Mr-Clear/FunzelBoard/KiCad/FunzlBoard.stl

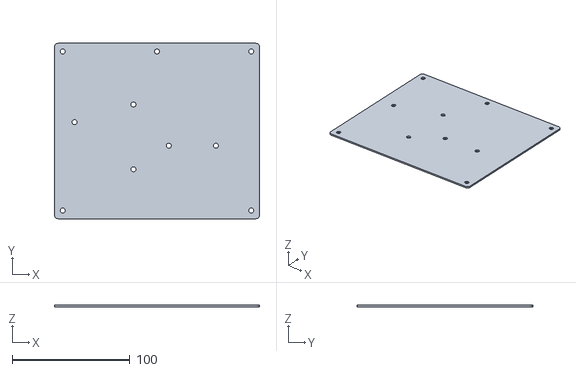
[picture p1: CAD file, 2025-11-04]
KiCad/FunzlBoard.stl
174.0 x 149.0 x 1.51
