Mr-Clear/FunzelBoard/KiCad/FunzlBoard.kicad_pcb

## KiCad design KiCad/FunzlBoard.kicad_pcb (2025-11-17)

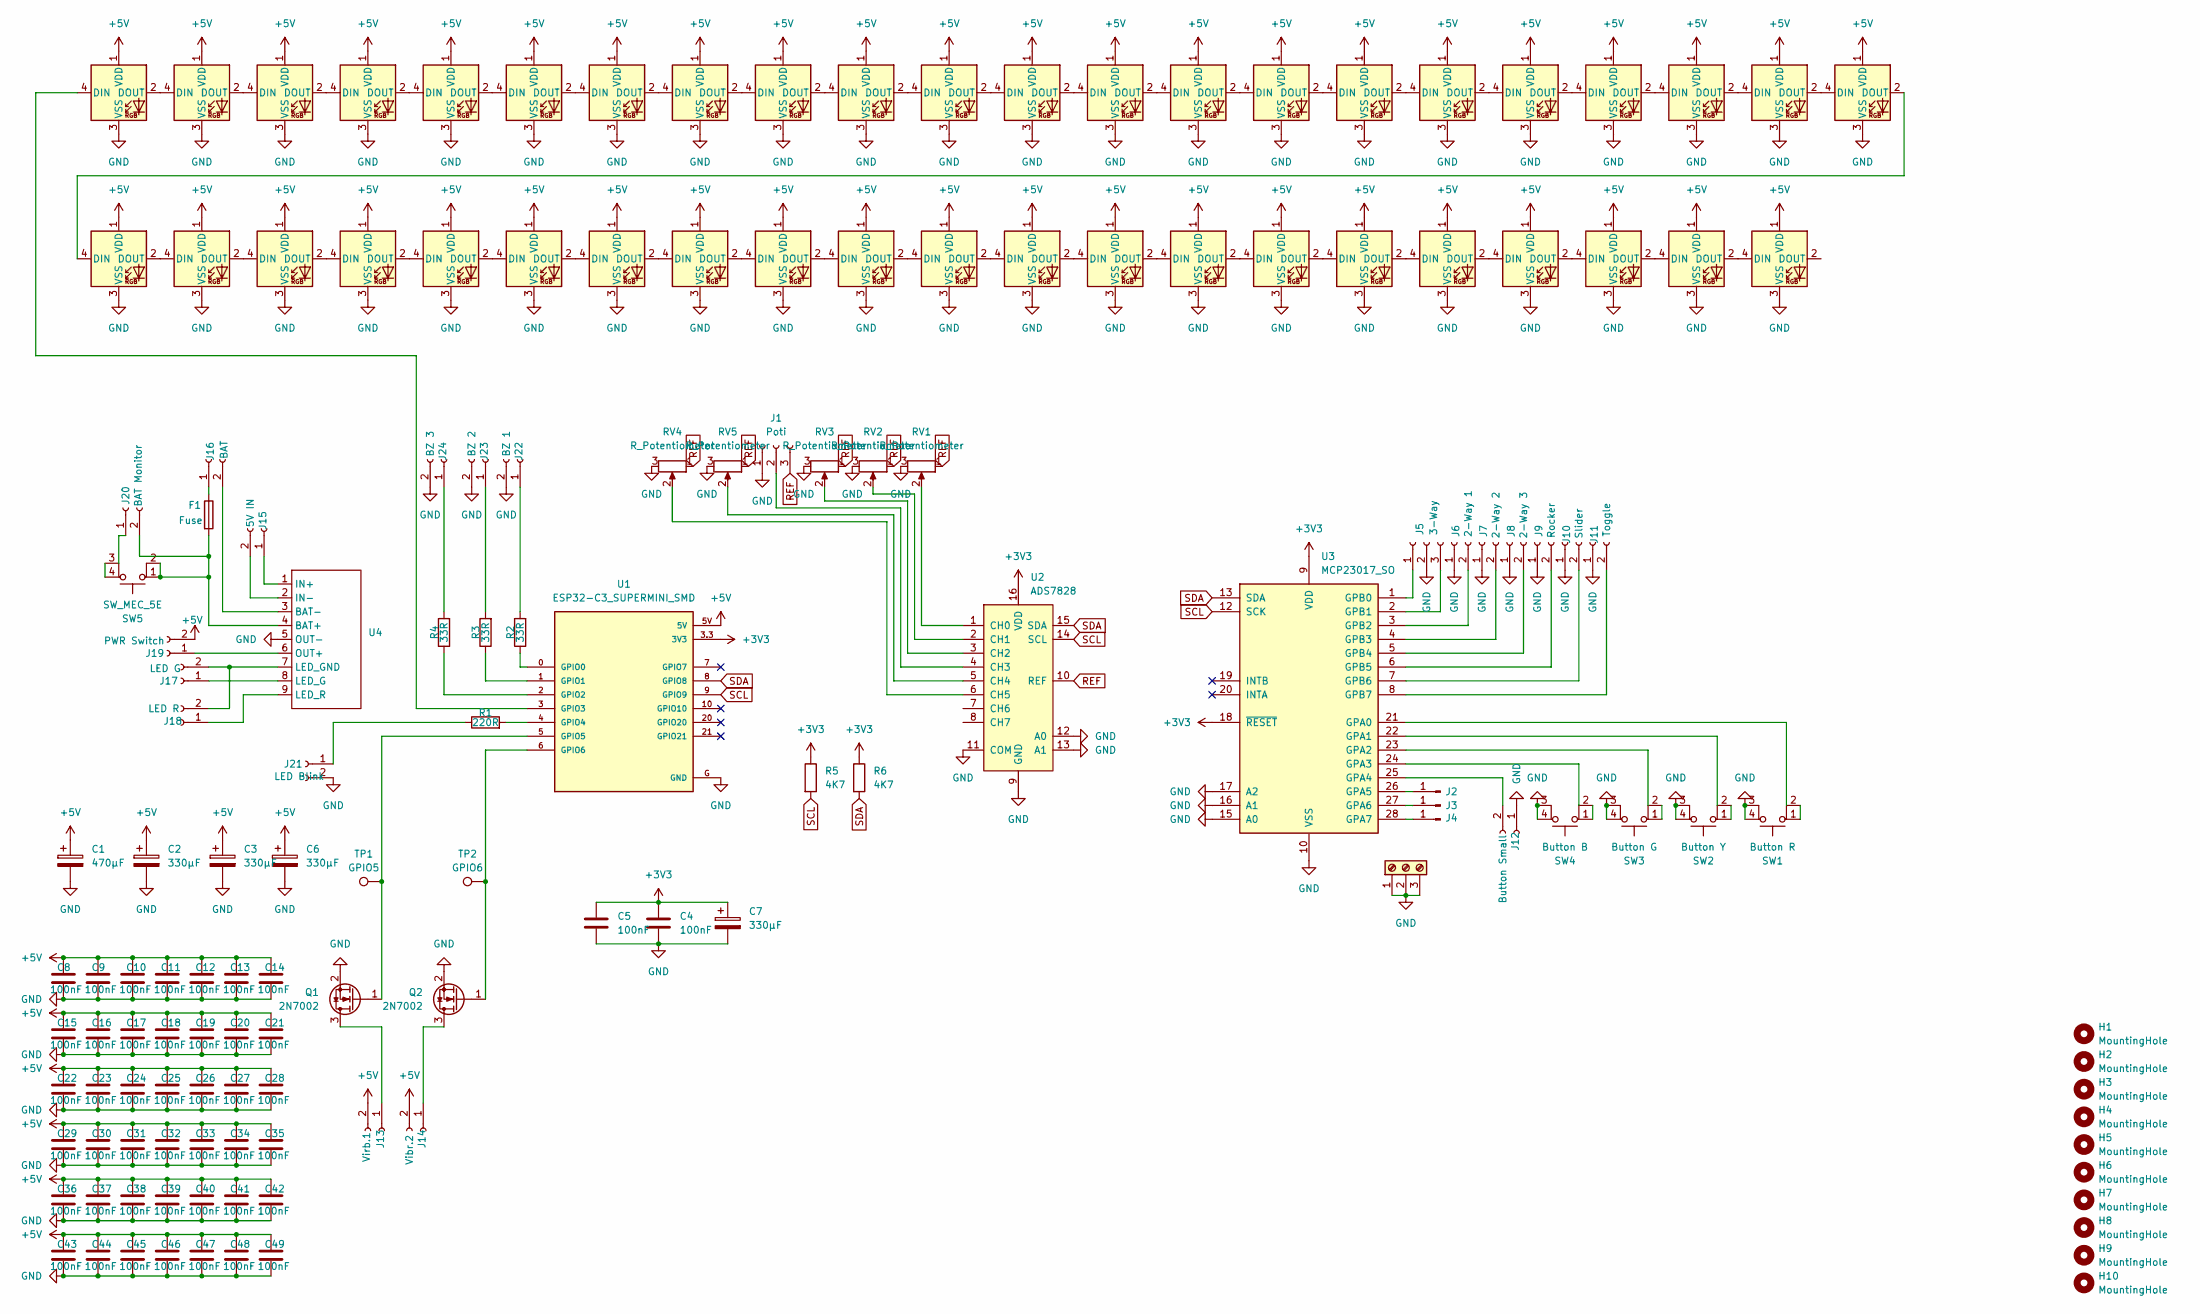
[picture p2: schematic FunzlBoard.kicad_sch]

Parts:
1WI1: Banana Plug Cable; TerminalBlock_Phoenix_MPT-0,5-3-2.54_1x03_P2.54mm_Horizontal
C1: 470µF; CP_Radial_D6.3mm_P2.50mm
C2, C3, C6, C7: 330µF; CP_Radial_D6.3mm_P2.50mm
C4, C5, C8, C9, C10, C11, C12, C13, C14, C15, C16, C17, C18, C19, C20, C21, C22, C23, C24, C25, C26, C27, C28, C29, C30, C31, C32, C33, C34, C35, C36, C37, C38, C39, C40, C41, C42, C43, C44, C45, C46, C47, C48, C49: 100nF; C_1206_3216Metric
D1, D2, D3, D4, D5, D6, D7, D8, D9, D10, D11, D12, D13, D14, D15, D16, D17, D18, D19, D20, D21, D22, D23, D24, D25, D26, D27, D28, D29, D30, D31, D32, D33, D34, D35, D36, D37, D38, D39, D40, D41, D42, D43: WS2812B; LED_WS2812B_PLCC4_5.0x5.0mm_P3.2mm
F1: Fuse; Fuseholder_Clip-5x20mm_Littelfuse_111_Inline_P20.00x5.00mm_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
H1, H2, H3, H4, H5, H6, H7, H8, H9, H10: MountingHole; MountingHole_4.3mm_M4_DIN965
J1: Poti; Connector3
J2: Banana Plug Socket 1; PinHeader_1x01_P2.54mm_Horizontal
J3: Banana Plug Socket 2; PinHeader_1x01_P2.54mm_Horizontal
J4: Banana Plug Socket 3; PinHeader_1x01_P2.54mm_Horizontal
J5: 3-Way; Connector3
J6: 2-Way 1; Connector2
J7: 2-Way 2; Connector2
J8: 2-Way 3; Connector2
J9: Rocker; Connector2
J10: Slider; Connector2
J11: Toggle; Connector2
J12: Button Small; Connector2
J13: Virb.1; Connector2
J14: Vibr.2; Connector2
J15: 5V IN; Connector2
J16: BAT; Connector2
J17: LED G; Connector2
J18: LED R; Connector2
J19: PWR Switch; Connector2
J20: BAT Monitor; Connector2
J21: LED Blink; Connector2
J22: BZ 1; Connector2
J23: BZ 2; Connector2
J24: BZ 3; Connector2
Q1, Q2: 2N7002; SOT-23
R1: 220R; R_1206_3216Metric
R2, R3, R4: 33R; R_1206_3216Metric
R5, R6: 4K7; R_1206_3216Metric
RV1, RV2, RV3: R_Potentiometer; Slider
RV4, RV5: R_Potentiometer; TrimmerH
SW1: Button R; ColorButton
SW2: Button Y; ColorButton
SW3: Button G; ColorButton
SW4: Button B; ColorButton
SW5: SW_MEC_5E; SW_PUSH_6mm_H13mm
TP1: GPIO5; TestPoint_THTPad_D1.5mm_Drill0.7mm
TP2: GPIO6; TestPoint_THTPad_D1.5mm_Drill0.7mm
U1: ESP32-C3_SUPERMINI_SMD; MODULE_ESP32-C3_SUPERMINI
U2: ADS7828; TSSOP-16_4.4x5mm_P0.65mm
U3: MCP23017_SO; SOIC-28W_7.5x17.9mm_P1.27mm
U4: Battery_Management

Connections:
+3V3: C4.1, C5.1, C7.1, R5.1, R6.1, U1.3.3 (3V3), U2.16 (VDD), U3.9 (VDD), U3.18 (~RESET)
+5V: C1.1, C2.1, C3.1, C6.1, C8.1, C9.1, C10.1, C11.1, C12.1, C13.1, C14.1, C15.1, C16.1, C17.1, C18.1, C19.1, C20.1, C21.1, C22.1, C23.1, C24.1, C25.1, C26.1, C27.1, C28.1, C29.1, C30.1, C31.1, C32.1, C33.1, C34.1, C35.1, C36.1, C37.1, C38.1, C39.1, C40.1, C41.1, C42.1, C43.1, C44.1, C45.1, C46.1, C47.1, C48.1, C49.1, D1.1 (VDD), D2.1 (VDD), D3.1 (VDD), D4.1 (VDD), D5.1 (VDD), D6.1 (VDD), D7.1 (VDD), D8.1 (VDD), D9.1 (VDD), D10.1 (VDD), D11.1 (VDD), D12.1 (VDD), D13.1 (VDD), D14.1 (VDD), D15.1 (VDD), D16.1 (VDD), D17.1 (VDD), D18.1 (VDD), D19.1 (VDD), D20.1 (VDD), D21.1 (VDD), D22.1 (VDD), D23.1 (VDD), D24.1 (VDD), D25.1 (VDD), D26.1 (VDD), D27.1 (VDD), D28.1 (VDD), D29.1 (VDD), D30.1 (VDD), D31.1 (VDD), D32.1 (VDD), D33.1 (VDD), D34.1 (VDD), D35.1 (VDD), D36.1 (VDD), D37.1 (VDD), D38.1 (VDD), D39.1 (VDD), D40.1 (VDD), D41.1 (VDD), D42.1 (VDD), D43.1 (VDD), J13.2, J14.2, J19.2, U1.5V
GND: 1WI1.1 (GND), 1WI1.2 (GND), 1WI1.3 (GND), C1.2, C2.2, C3.2, C4.2, C5.2, C6.2, C7.2, C8.2, C9.2, C10.2, C11.2, C12.2, C13.2, C14.2, C15.2, C16.2, C17.2, C18.2, C19.2, C20.2, C21.2, C22.2, C23.2, C24.2, C25.2, C26.2, C27.2, C28.2, C29.2, C30.2, C31.2, C32.2, C33.2, C34.2, C35.2, C36.2, C37.2, C38.2, C39.2, C40.2, C41.2, C42.2, C43.2, C44.2, C45.2, C46.2, C47.2, C48.2, C49.2, D1.3 (VSS), D2.3 (VSS), D3.3 (VSS), D4.3 (VSS), D5.3 (VSS), D6.3 (VSS), D7.3 (VSS), D8.3 (VSS), D9.3 (VSS), D10.3 (VSS), D11.3 (VSS), D12.3 (VSS), D13.3 (VSS), D14.3 (VSS), D15.3 (VSS), D16.3 (VSS), D17.3 (VSS), D18.3 (VSS), D19.3 (VSS), D20.3 (VSS), D21.3 (VSS), D22.3 (VSS), D23.3 (VSS), D24.3 (VSS), D25.3 (VSS), D26.3 (VSS), D27.3 (VSS), D28.3 (VSS), D29.3 (VSS), D30.3 (VSS), D31.3 (VSS), D32.3 (VSS), D33.3 (VSS), D34.3 (VSS), D35.3 (VSS), D36.3 (VSS), D37.3 (VSS), D38.3 (VSS), D39.3 (VSS), D40.3 (VSS), D41.3 (VSS), D42.3 (VSS), D43.3 (VSS), J1.1, J5.2, J6.1, J7.1, J8.1, J9.1, J10.1, J11.1, J12.1, J21.2, J22.2, J23.2, J24.2, Q1.2 (S), Q2.2 (S), RV1.3, RV2.3, RV3.3, RV4.3, RV5.3, SW1.3 (K), SW1.4 (A), SW2.3 (K), SW2.4 (A), SW3.3 (K), SW3.4 (A), SW4.3 (K), SW4.4 (A), U1.G (GND), U2.9 (GND), U2.11 (COM), U2.12 (A0), U2.13 (A1), U3.10 (VSS), U3.15 (A0), U3.16 (A1), U3.17 (A2), U4.5 (OUT-)
unnamed: D1.4 (DIN), U1.3 (GPIO3)
unnamed: D1.2 (DOUT), D2.4 (DIN)
unnamed: D2.2 (DOUT), D3.4 (DIN)
unnamed: D3.2 (DOUT), D4.4 (DIN)
unnamed: D4.2 (DOUT), D5.4 (DIN)
unnamed: D5.2 (DOUT), D6.4 (DIN)
unnamed: D6.2 (DOUT), D7.4 (DIN)
unnamed: D7.2 (DOUT), D8.4 (DIN)
unnamed: D8.2 (DOUT), D9.4 (DIN)
unnamed: D9.2 (DOUT), D10.4 (DIN)
unnamed: D10.2 (DOUT), D11.4 (DIN)
unnamed: D11.2 (DOUT), D12.4 (DIN)
unnamed: D12.2 (DOUT), D13.4 (DIN)
unnamed: D13.2 (DOUT), D14.4 (DIN)
unnamed: D14.2 (DOUT), D15.4 (DIN)
unnamed: D15.2 (DOUT), D16.4 (DIN)
unnamed: D16.2 (DOUT), D17.4 (DIN)
unnamed: D17.2 (DOUT), D18.4 (DIN)
unnamed: D18.2 (DOUT), D19.4 (DIN)
unnamed: D19.2 (DOUT), D20.4 (DIN)
unnamed: D20.2 (DOUT), D21.4 (DIN)
unnamed: D21.2 (DOUT), D22.4 (DIN)
unnamed: D22.2 (DOUT), D23.4 (DIN)
unnamed: D23.2 (DOUT), D24.4 (DIN)
unnamed: D24.2 (DOUT), D25.4 (DIN)
unnamed: D25.2 (DOUT), D26.4 (DIN)
unnamed: D26.2 (DOUT), D27.4 (DIN)
unnamed: D27.2 (DOUT), D28.4 (DIN)
unnamed: D28.2 (DOUT), D29.4 (DIN)
unnamed: D29.2 (DOUT), D30.4 (DIN)
unnamed: D30.2 (DOUT), D31.4 (DIN)
unnamed: D31.2 (DOUT), D32.4 (DIN)
unnamed: D32.2 (DOUT), D33.4 (DIN)
unnamed: D33.2 (DOUT), D34.4 (DIN)
unnamed: D34.2 (DOUT), D35.4 (DIN)
unnamed: D35.2 (DOUT), D36.4 (DIN)
unnamed: D36.2 (DOUT), D37.4 (DIN)
unnamed: D37.2 (DOUT), D38.4 (DIN)
unnamed: D38.2 (DOUT), D39.4 (DIN)
unnamed: D39.2 (DOUT), D40.4 (DIN)
unnamed: D40.2 (DOUT), D41.4 (DIN)
unnamed: D41.2 (DOUT), D42.4 (DIN)
unnamed: D42.2 (DOUT), D43.4 (DIN)
unnamed: J1.2, U2.4 (CH3)
unnamed: J2.1, U3.26 (GPA5)
unnamed: J3.1, U3.27 (GPA6)
unnamed: J4.1, U3.28 (GPA7)
unnamed: J5.1, U3.1 (GPB0)
unnamed: J5.3, U3.2 (GPB1)
unnamed: J6.2, U3.3 (GPB2)
unnamed: J7.2, U3.4 (GPB3)
unnamed: J8.2, U3.5 (GPB4)
unnamed: J9.2, U3.6 (GPB5)
unnamed: J10.2, U3.7 (GPB6)
unnamed: J11.2, U3.8 (GPB7)
unnamed: J12.2, U3.25 (GPA4)
unnamed: J13.1, Q1.3 (D)
unnamed: J14.1, Q2.3 (D)
unnamed: J15.1, U4.1 (IN+)
unnamed: J15.2, U4.2 (IN-)
unnamed: F1.1, J16.1
unnamed: J16.2, U4.3 (BAT-)
unnamed: J17.1, U4.8 (LED_G)
unnamed: J17.2, J18.2, U4.7 (LED_GND)
unnamed: J18.1, U4.9 (LED_R)
unnamed: J19.1, U4.6 (OUT+)
unnamed: F1.2, J20.2, SW5.1, SW5.2, U4.4 (BAT+)
unnamed: J21.1, R1.1
unnamed: J22.1, R2.2
unnamed: J23.1, R3.2
unnamed: J24.1, R4.2
unnamed: Q1.1 (G), TP1.1, U1.5 (GPIO5)
unnamed: Q2.1 (G), TP2.1, U1.6 (GPIO6)
unnamed: SW1.1, SW1.2
unnamed: SW2.1, SW2.2
unnamed: SW3.1, SW3.2
unnamed: SW4.1, SW4.2
unnamed: SW5.3 (K), SW5.4 (A)
unnamed: R2.1, U1.0 (GPIO0)
unnamed: R3.1, U1.1 (GPIO1)
unnamed: R4.1, U1.2 (GPIO2)
unnamed: R1.2, U1.4 (GPIO4)
unnamed: RV1.2, U2.1 (CH0)
unnamed: RV2.2, U2.2 (CH1)
unnamed: RV3.2, U2.3 (CH2)
unnamed: RV5.2, U2.5 (CH4)
unnamed: RV4.2, U2.6 (CH5)
REF: J1.3, RV1.1, RV2.1, RV3.1, RV4.1, RV5.1, U2.10 (REF)
SCL: R5.2, U1.9 (GPIO9), U2.14 (SCL), U3.12 (SCK)
SDA: R6.2, U1.8 (GPIO8), U2.15 (SDA), U3.13 (SDA)

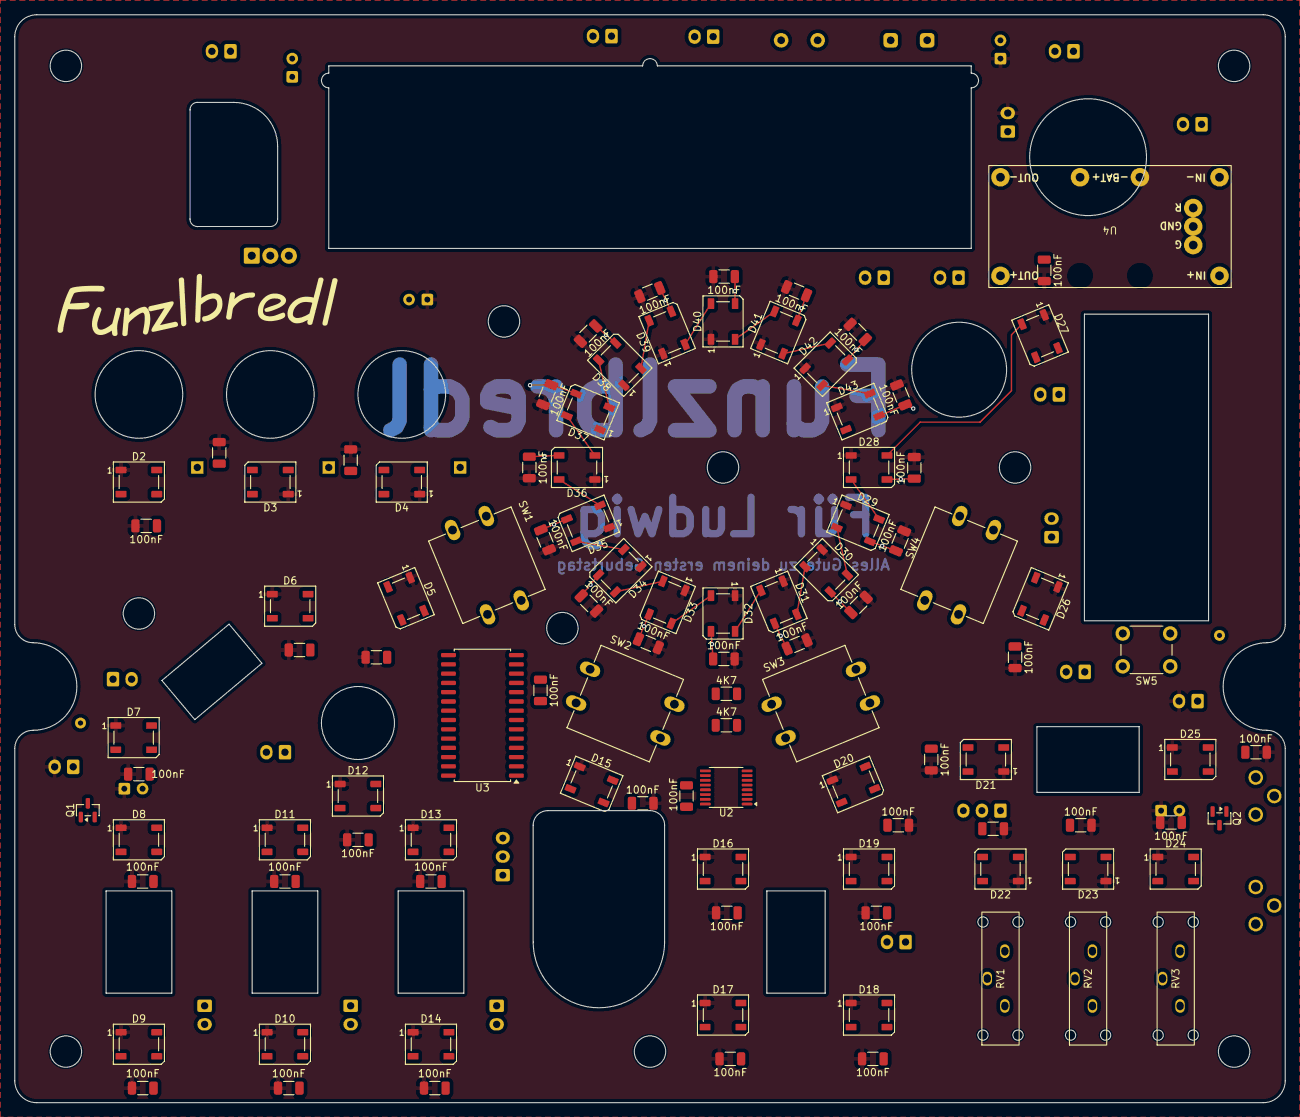
[picture p3: board FunzlBoard.kicad_pcb from above]

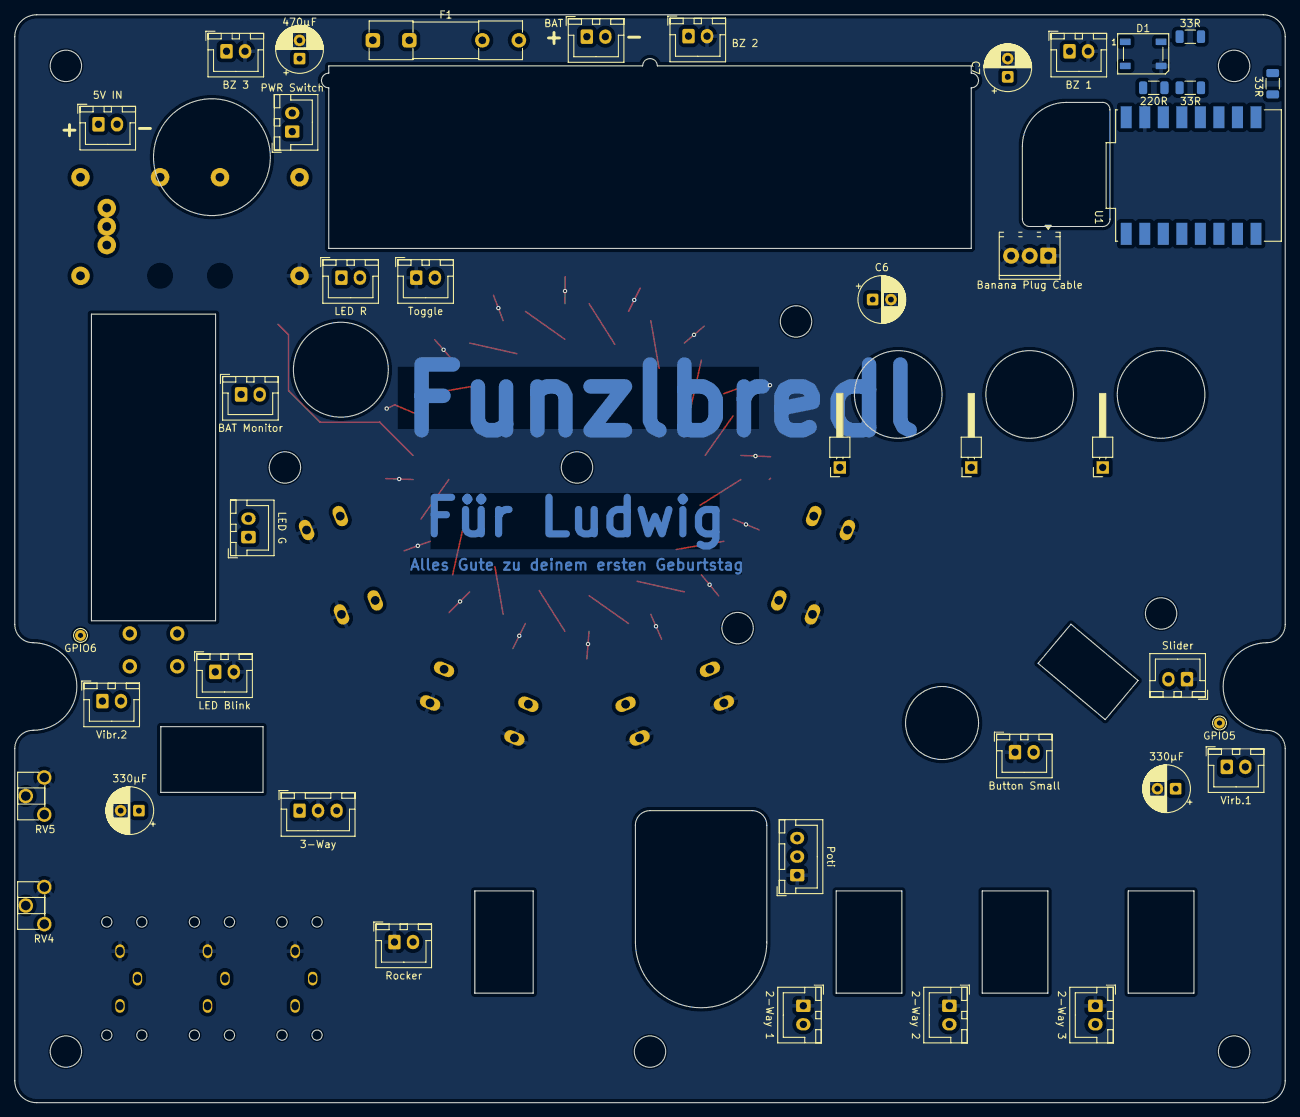
[picture p4: board FunzlBoard.kicad_pcb from below]

Board: 2 copper layers, 174.0 x 149.0 mm, 152 parts (41 on the bottom side), 93 nets.
