Mr-Clear/FunzelBoard/(commit log)

2025-10-14 Read ADC values
2025-10-14 Scan I2C on command
2025-10-17 Read button states
2025-10-19 Add Slider Knob
    [slider.scad]
2025-10-19 Drive motor
2025-10-19 Replace Action classes by plain functions
    [logic.cpp, octaves.cpp]
2025-10-24 Hover track
2025-10-25 Frame select notes
2025-10-26 Indicate buzzer with fill color
    [config.py, main_window.py, song.py, song_widget.py]
2025-10-26 Set buzzer of selected notes
    [notes_list_widget.py]
2025-10-26 Edit track title
2025-10-26 Move track up/down
2025-10-26 Select all notes in track
2025-10-26 Highlight track and note
2025-11-02 Replace ADS1115 by ADS7828
    [adc.cpp, adc.h, config.h, main.cpp]
2025-11-02 Add KiCad project
    [KiCad.kicad_pcb]
2025-11-02 Add LED cap
    [LedCap.scad, Slider.scad]
2025-11-02 Normalize ADC readings
2025-11-04 Color float on button press
2025-11-04 Create 3d model
    [BananaJack.scad, Battery.scad, BatteryIndicator.scad, CableEntry.scad, ColorButton.scad, DipButton.scad, FunzlBoard.scad, Led.scad]
2025-11-04 Restart KiCad project
    [FunzlBoard.kicad_pcb, FunzlBoard.kicad_sch, KiCad.kicad_pcb]
2025-11-04 Add main screw holes
    [FunzlBoard.kicad_pcb, FunzlBoard.kicad_sch]
2025-11-04 Show mainboard in OpenSCAD
    [FunzlBoard.kicad_pcb, FunzlBoard.scad, FunzlBoard.stl]
2025-11-07 Cut out for battery
    [FunzlBoard.kicad_pcb, FunzlBoard.kicad_sch, FunzlBoard.scad, Switch.scad]
2025-11-14 Use sleeve in led cap
    [Battery.scad, FunzlBoard.scad, LedCap.scad, Switch.scad]
2025-11-14 Chacnge pin layout to 16-Pin Super Mini
2025-11-14 Align LEDs on main board
    [FunzlBoard.kicad_pcb, FunzlBoard.kicad_sch, FunzlBoard.scad]
2025-11-15 Add main screws
    [FunzlBoard.scad, Screws.scad]
2025-11-15 Add screws to mount components
    [Battery.scad, FunzlBoard.scad, RockerSwitch.scad, Screws.scad, SlideSwitch.scad]
2025-11-15 Cut out board for components
    [FunzlBoard.kicad_pcb, FunzlBoard.kicad_sch]
2025-11-15 Add Color Buttons to PCB
    [FunzlBoard.kicad_pcb, FunzlBoard.kicad_sch]
2025-11-15 Add footprints for sliders
    [FunzlBoard.kicad_pcb, FunzlBoard.kicad_sch, Slider.scad]
2025-11-15 Add DIP Switch to PCB
    [FunzlBoard.kicad_pcb, FunzlBoard.kicad_sch]
2025-11-15 Add slider footprint
2025-11-16 Move a screw
    [FunzlBoard.kicad_pcb, FunzlBoard.kicad_sch, FunzlBoard.scad]
2025-11-16 Add Trimmer
    [FunzlBoard.kicad_pcb, FunzlBoard.kicad_sch, FunzlBoard.scad, Trimmer.scad]
2025-11-16 Fix motor pin
2025-11-16 Add trimmer and vibrators
    [Fillet.scad, FunzlBoard.kicad_pcb, FunzlBoard.scad, Pipe.scad, TrimmerH.scad, Vibrator.scad]
2025-11-16 Add connectors
    [FunzlBoard.kicad_pcb, FunzlBoard.kicad_sch]
2025-11-17 Add 2nd trimmer
    [FunzlBoard.kicad_pcb, FunzlBoard.kicad_sch, FunzlBoard.scad]
2025-11-17 Add Battery Management to OpenSCAD
    [BatteryManagement.scad, FunzlBoard.kicad_pcb, FunzlBoard.scad]
2025-11-17 Place capas
    [FunzlBoard.kicad_pcb, FunzlBoard.kicad_sch]
2025-11-17 Add fuse
    [FunzlBoard.kicad_pcb, FunzlBoard.kicad_sch]
2025-11-17 Make space for battery
    [Battery.scad, FunzlBoard.scad, Vibrator.scad]
2025-11-17 Add screws for battery indicator
    [BatteryIndicator.scad, FunzlBoard.scad, Screws.scad]
